xtensa/xarias/README.md

## XARIAS carputer project

For details about project please go to the WIKI branch: https://github.com/xtensa/xarias/blob/wiki/README.md

xarias board
