xtensa/xarias/schematics/symbols/7414.ods

# This is the template file for creating symbols with tragesym
# every line starting with '#' is a comment line.
# save it as text file with tab separated cells and start tragesym
[options]
# wordswap swaps labels if the pin is on the right side an looks like this:
# "PB1 (CLK)". That's useful for micro controller port labels
# rotate_labels rotates the pintext of top and bottom pins
# this is useful for large symbols like FPGAs with more than 100 pins
# sort_labels will sort the pins by it's labels
# useful for address ports, busses, ...
wordswap | no
rotate_labels | no
sort_labels | yes
generate_pinseq | yes
sym_width | 1400
pinwidthvertical | 400
pinwidthhorizontal | 400
[geda_attr]
# name will be printed in the top of the symbol
# if you have a device with slots, you'll have to use slot= and slotdef=
# use comment= if there are special information you want to add
version | 20060113 1
name | 7414
device
refdes | U?
footprint
description | Schmidt Trigger Set
documentation | somewhere in net :)
author | rp9
numslots | 0
#dist-license
#use-license
#slot | 1
#slotdef | 1:
#slotdef | 2:
#slotdef | 3:
#slotdef | 4:
#comment
#comment
#comment
[pins]
# tabseparated list of pin descriptions
#
# pinnr is the physical number of the pin
# seq is the pinseq= attribute, leave it blank if it doesn't matter
# type can be (in, out, io, oc, oe, pas, tp, tri, clk, pwr)
# style can be (line,dot,clk,dotclk,none). none if only want to add a net
# posit. can be (l,r,t,b) or empty for nets
# net specifies the name of the net. Vcc or GND for example.
# label represents the pinlabel.
# | negation lines can be added with "\_" example: \_enable\_
# | if you want to write a "\" use "\\" as escape sequence
#
#pinnr | seq | type | style | posit. | net | label
1 |  |  | line | l |  | 1A
2 |  |  | line | l |  | 1Y
3 |  |  | line | l |  | 2A
4 |  |  | line | l |  | 2Y
5 |  |  | line | l |  | 3A
6 |  |  | line | l |  | 3Y
7 |  |  | line | l |  | GND
14 |  |  | line | r |  | VCC
13 |  |  | line | r |  | 6A
12 |  |  | line | r |  | 6Y
11 |  |  | line | r |  | 5A
10 |  |  | line | r |  | 5Y
9 |  |  | line | r |  | 4A
8 |  |  | line | r |  | 4Y
