xtensa/xarias/schematics/b01/main_board.png

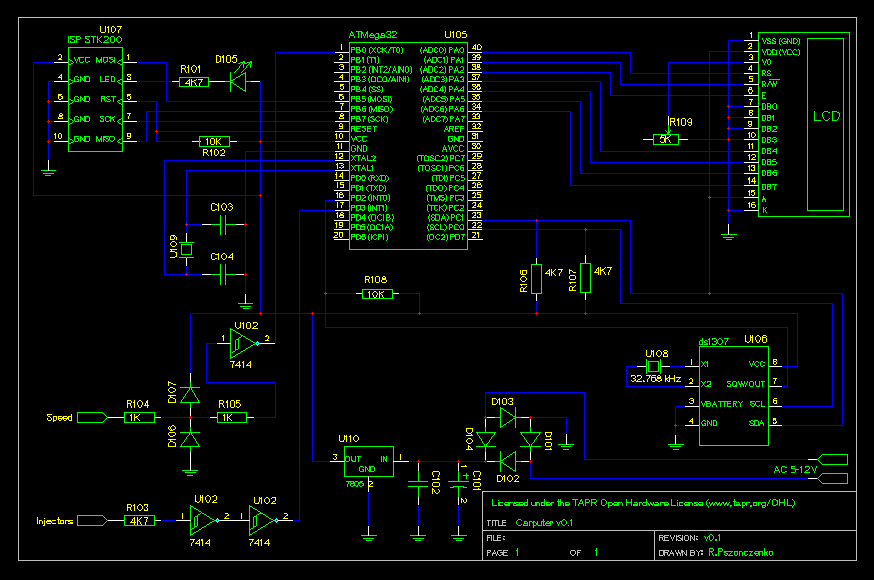
schematics/b01/main_board.png
