xtensa/xarias/schematics/b02/ac_board.pdf

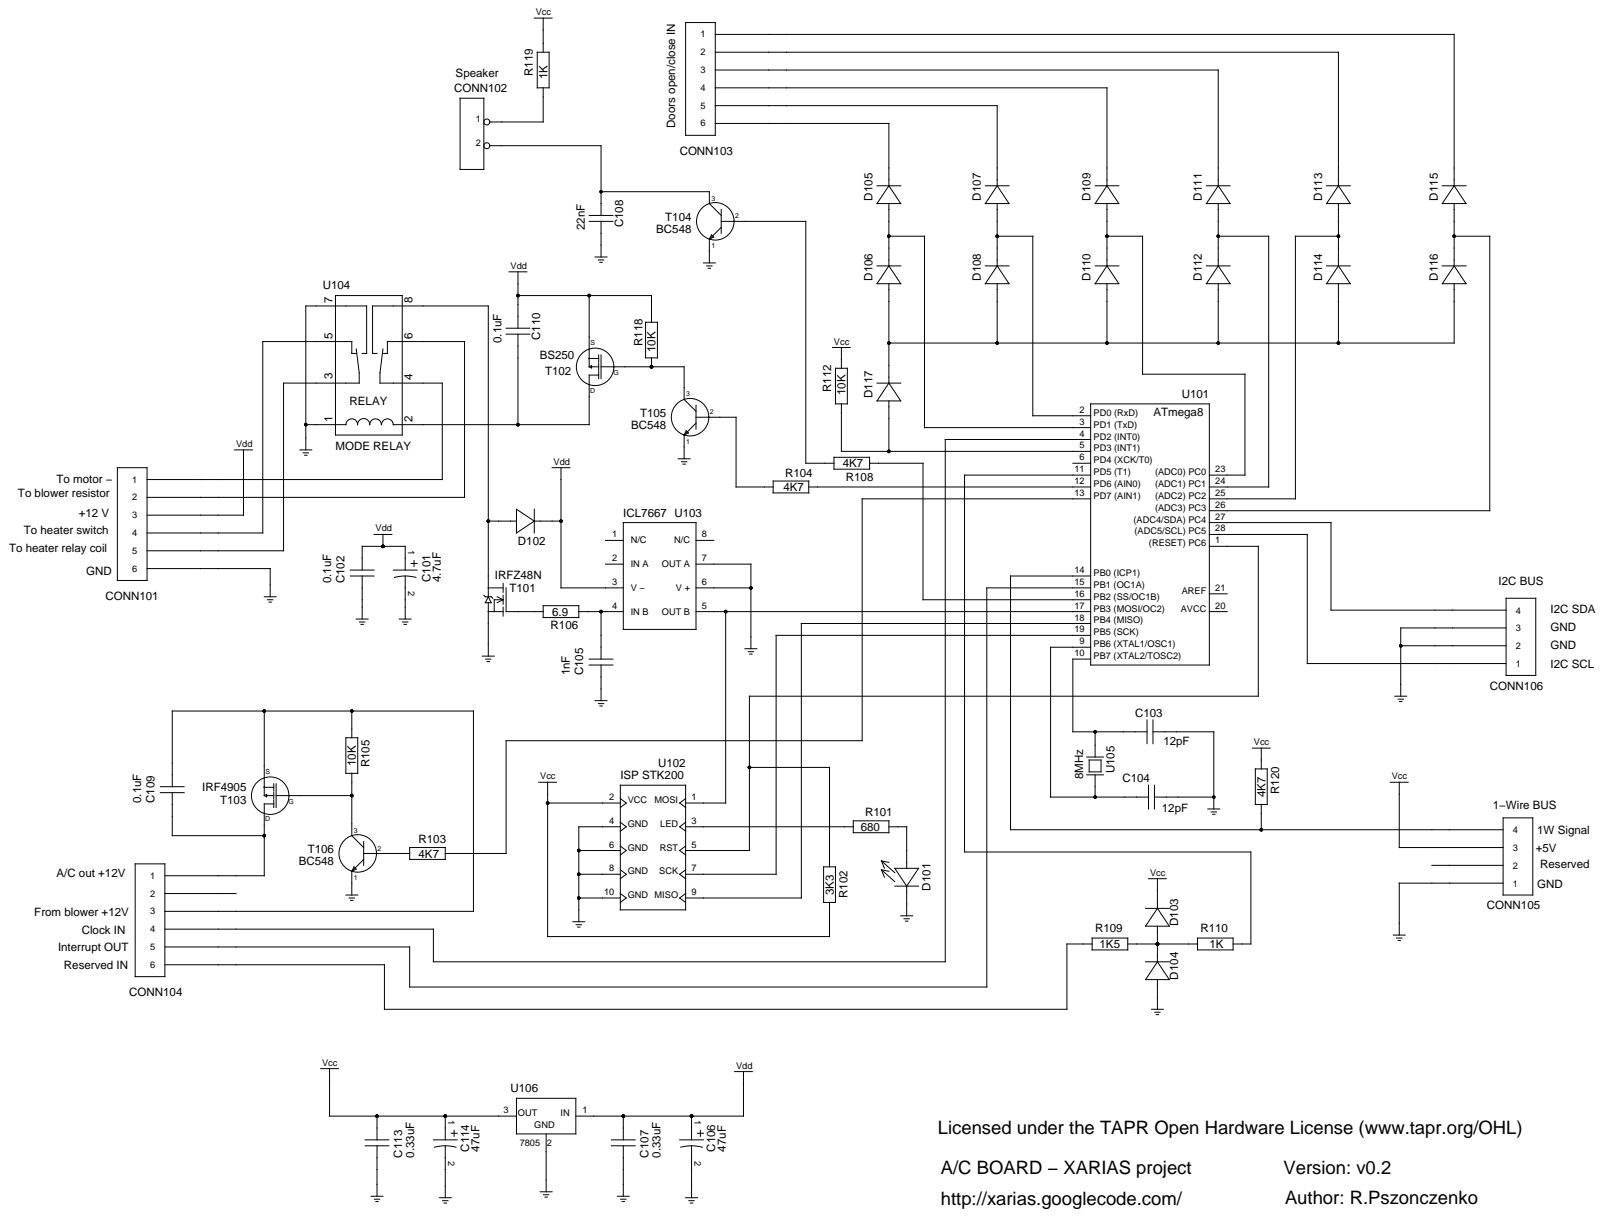
[picture p2: page 1]

Doors open/close IN

To heater switch
To heater relay coil

Licensed under the TAPR Open Hardware License (www.tapr.org/OHL)
A/C BOARD − XARIAS project
http://xarias.googlecode.com/
