xtensa/xarias/schematics/b02/main_board.pdf

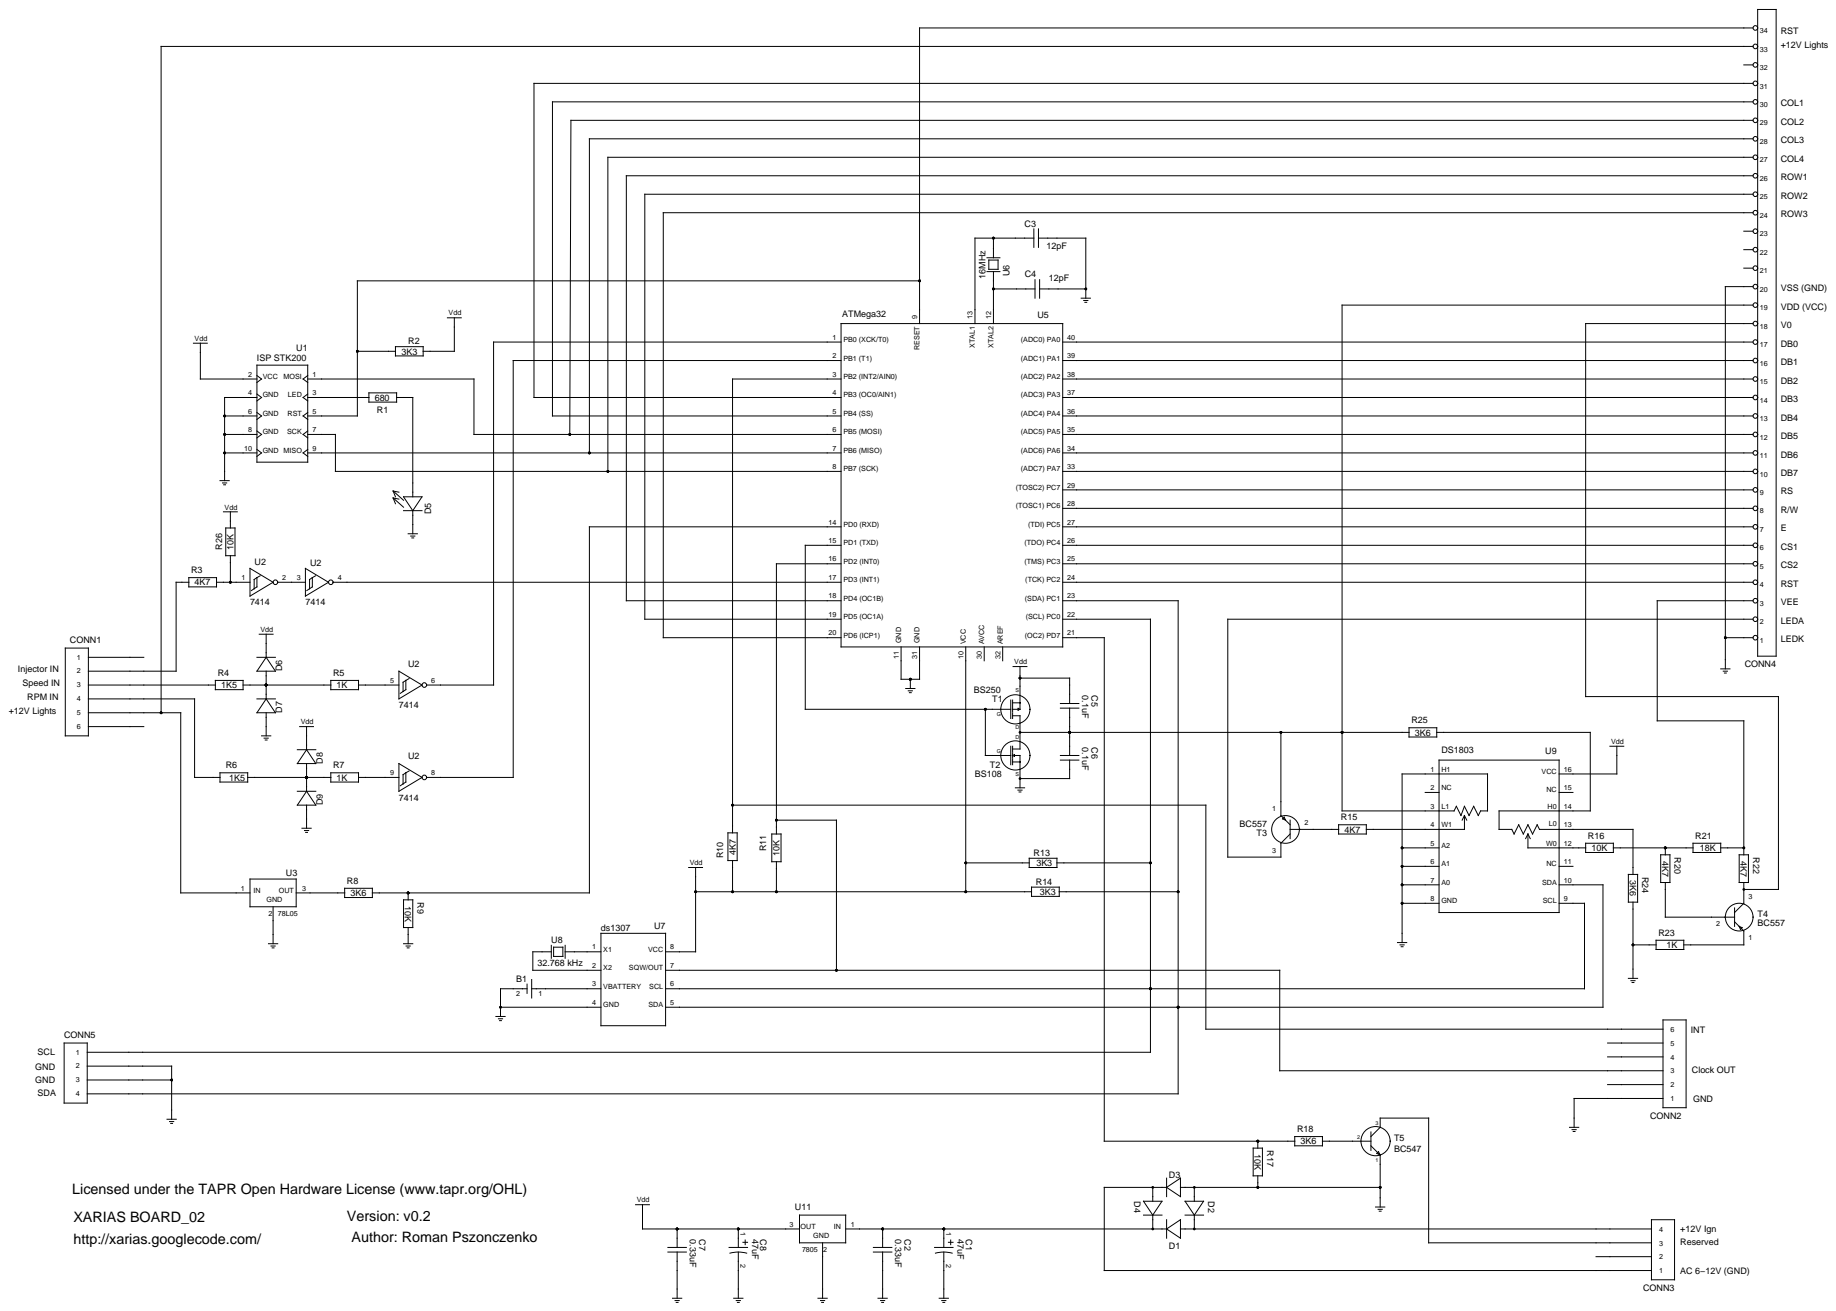
[picture p3: page 1]

28 (TOSC1) PC6

27 (TDI) PC5

Licensed under the TAPR Open Hardware License (www.tapr.org/OHL)
XARIAS BOARD_02
