xtensa/xarias/(list of files, drawings)

Other design files:
schematics/b02/ac_board_v0.1.pcb
schematics/b02/xarias_b0.2.pcb
