xtensa/xarias/(commit log)

2007-09-29 First varsion in SVN. Yes it works. But there is a bug that resets passed kilometers counter after about 40km. Probably some variable overflow.
    [hd44780.c, lcd.c, lcd.h]
2007-09-29 First version of schematics. It's just electronic version of what was done on cardboard, spending hours on development.
    [7414.csv, 7414.ods, at32_tpl.csv, at32_tpl.ods, isp_stk200.csv, isp_stk200.ods, main_board.sch]
2007-10-17 - roundation bug fixed that caused limitation of maximum path to 65 km. and 535 m. :) - added journey timer
2007-10-17 Created scheme v1.0 directory. This scheme is designed for 20x4 LCD display.
    [main_board.sch]
2007-12-19 Renaming catalog v1.0 to v0.1 as it was a mistake.
    [main_board.sch]
2007-12-19 PNG schematics added
2007-12-19 Added licence notes and created some docs.
    [main_board.sch]
2007-12-20 Directory v0.1 renamed to b0.1 (b stands for board).
    [main_board.sch]
2007-12-30 Added LCD to schematics and corected some small mistakes.
    [main_board.sch]
2007-12-30 Directory b0.1 is renamed to b01
    [main_board.sch]
2007-12-30 Corrected mistake in power supply circuit.
    [main_board.sch]
2008-01-04 Working version - just for not loosing.
    [main_board.sch]
2008-01-12 Added number of new symbols and footprints. Also commited almost final version of b02 main boad. Not checked yet.
    [main_board.sch]
2008-01-13 Almost finished v0.2
    [main_board.sch]
2008-01-13 Added CR2032 battery footprint.
2008-01-14 Board b02 v0.2 final.
    [main_board.sch]
2008-01-15 Added RESET net and first version of PCB prepared.
    [main_board.sch, xarias_b0.2.pcb]
2008-01-17 Some mistakes corrected (diode pins). Final layout created. Board ready for printing.
    [main_board.sch, xarias_b0.2.pcb]
2008-01-24 Firmware for board b02 is started. Driver for S6B0108 display is working and almost ready.
2008-01-24 Some bugs corrected in just added function
    [xarias_b02.c]
2008-01-24 Added several graphical functions for drawing pixel, line, to fille rectangle with the pattern and to draw a frame of specified width.
2008-01-26 LCD connection reconfigured. Now LCD is connected filly to porta A. The previous architecture slowed down r/w operations almost 8 times because every r/w operation caused 8 accesses to data ports.
    [main_board.sch]
2008-03-21 Graphic LCD driver (KS6B0108) is written and is quite stable but still there are some issues to be fixed.
    BMP image to binary converter has been finished.
    font5x7 created.
    XARIAS firmware v01 has been ported to v02 and generally
    works with graphic LCD.
    [gLCD.c, gLCD.h, s6b0108.c, xarias_b02.c, xarias_b02.h]
2008-04-17 New 16x24 font was added. Also three main modes created: SPEED, FUEL and TRIP
    [main_board.sch]
2008-04-19 "Trip settings" mode completed. Variables are correctly saved to DS1307 memory now.
    [gLCD.c, gLCD.h, twi_devs.c, twi_devs.h, xarias_b02.c, xarias_b02.h]
2008-04-20 New symbols added. Brightness and contrast part corrected so it really works now.
    [main_board.sch]
2008-04-20 PCB board updated for new DS1803 layout.
    [main_board.sch, xarias_b0.2.pcb]
2008-04-22 LCD power circuit changed to use negative gate on two mosfets.
    [main_board.sch, xarias_b0.2.pcb]
2008-04-26 A/C Board has been designed. Several bug fixes made to Main Board. ICL7667 and relay symbols were added.
    [main_board.sch, xarias_b0.2.pcb]
2008-04-26 A/C board finally designed. First tests with blower motor controlled by PWM done.
    [ac_board.sch, main_board.sch, xarias_b0.2.pcb]
2008-04-27 Several symbols and footprints added. Some test code for AC written (PWM motor testing).
    [ac_board.sch]
2008-04-27 Backup... Work in progress....
    [ac_board.sch, main_board.sch, xarias_b0.2.pcb]
2008-04-29 A/C pcb board has been designed
    [ac_board_v0.1.pcb]
2008-05-06 Several cleanups were made. defines.h has been renamed to xarias_b01.h as it was used only for b01 board. Errors handling was reorganised. Error routine is invoked from the most low-level functions a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
    [gLCD.c, gLCD.h, hd44780.c, lcd.c, twi_devs.c, xarias_ac.c, xarias_b01.c, xarias_b01.h]
2008-05-22 1-wire support has been added, as well as Dallas 18B20 thermometer routines. TWI slave support added for AC module and some commands were added that makes it possible to read temperature by main boar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
2008-05-27 Again, several cleanups were made. Added CRC check to 1-wire routines. Simple automatic A/C control is finally working.
2008-06-21 Several cleanups and bug fixes were made. Finaly the whole system tested in the car. Added first opened doors status support.
    [twi_devs.c, xarias_ac.c, xarias_ac.h, xarias_b02.c, xarias_b02.h]
2008-07-03 Additional capasitors added after stabilizer. AC 12V out is powered now from blower external blower relay. Some other bugfixes were made.
    [ac_board.sch, ac_board_v0.1.pcb, main_board.sch, xarias_b0.2.pcb]
2008-07-03 Keyboard schematics added
    [keyboard.sch, main_board.sch]
2008-07-06 AC board version changed to v0.2 because some improvements were made since first version.
    [ac_board.sch]
2008-07-06 Doors probing routine has been changed to not use interrupt. All doors are probed the times per secoond.
2008-07-07 Schematics PDFs added
2008-11-25 The following new functionality added: - turned off lights signal - b02 light board support (without AC interface) The following bugs fixed: - negative temperature bug - only first two 1-wire address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
    [one_wire.c, one_wire.h, xarias_ac.h, xarias_b02l.c]
2009-01-07 - bug fixed: wrong inside temperature sign - bug fixed: screen messed up if doors are opened or closed during screen refreshing - performance improvement: twi function for getting devices info splitt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
    [one_wire.c, one_wire.h, xarias_ac.c, xarias_ac.h, xarias_b02.c, xarias_b02l.c]
2009-01-19 * Corrected lights warning signal bug * Reorganized ds1307 memory map to prepare for several data sets functionality in the feature versions.
    [xarias_b02.c, xarias_b02.h]
2009-01-19 Switching to usbasp default programmer.
2009-03-15 Added possibility to invert CS lines. Some displays are not compliant with standarts and turning segments on not when CSx=0 but when CSx=1. This modification allows to adjust how CSx lines are turned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
    [gLCD.c, s6b0108.h]
2017-03-29 Fixes for newer gcc version
    [twi_devs.h, xarias_ac.c, xarias_b01.c, xarias_b02.c, xarias_b02l.c]
